G-EDM/G-EDM-Basic-Sinker-EDM-Tower/stl/cheap-bracket-for-12mm-shaft.stl

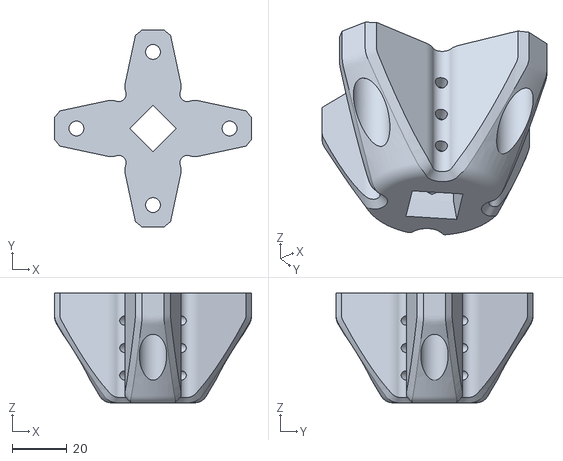
[picture p3: CAD file, 2025-10-24]
stl/cheap-bracket-for-12mm-shaft.stl
71.9 x 71.9 x 40.0
