G-EDM/G-EDM-Basic-Sinker-EDM-Tower/stl/z-motor-mount.stl

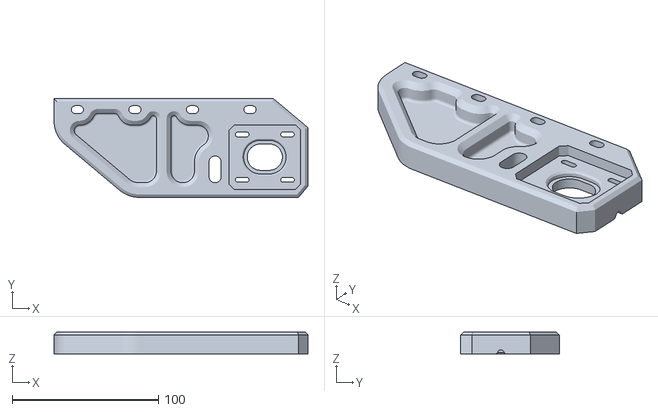
[picture p4: CAD file, 2025-10-24]
stl/z-motor-mount.stl
173.6 x 67.5 x 15.0
