G-EDM/G-EDM-Basic-Sinker-EDM-Tower/stl/stand-foot.stl

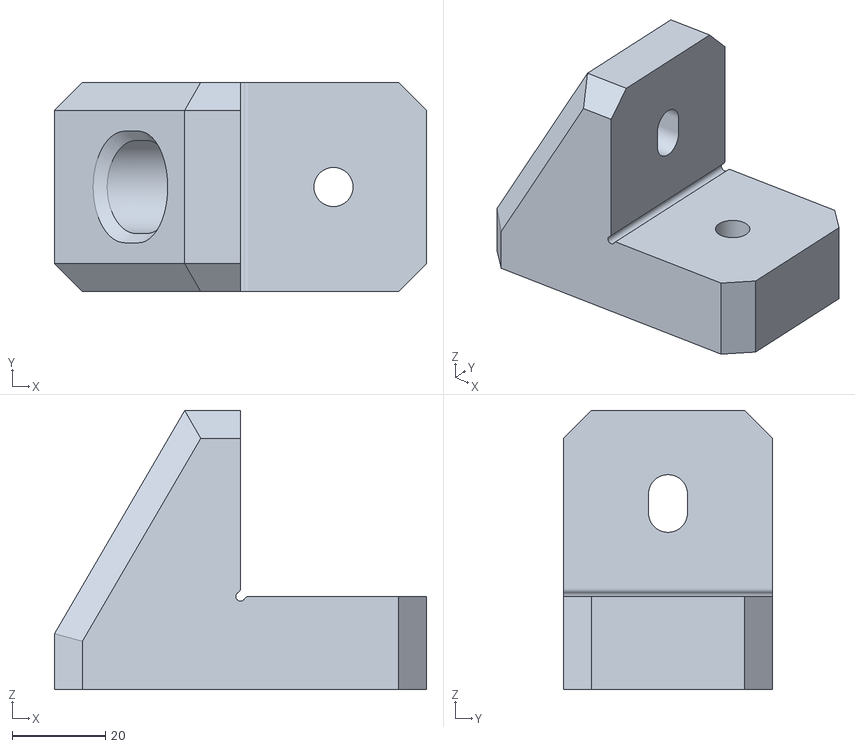
[picture p5: CAD file, 2025-10-24]
stl/stand-foot.stl
80.0 x 45.0 x 60.0
