G-EDM/G-EDM-Basic-Sinker-EDM-Tower/stl/z-slide.stl

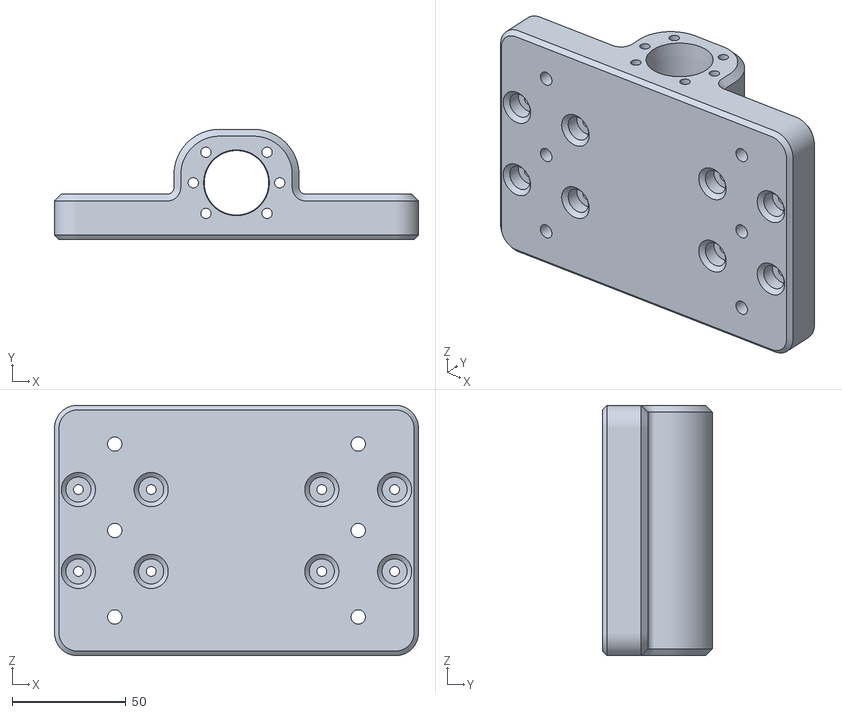
[picture p6: CAD file, 2025-10-24]
stl/z-slide.stl
160.0 x 48.5 x 110.0
